kipman725/Petri2/temp_accuracy.png

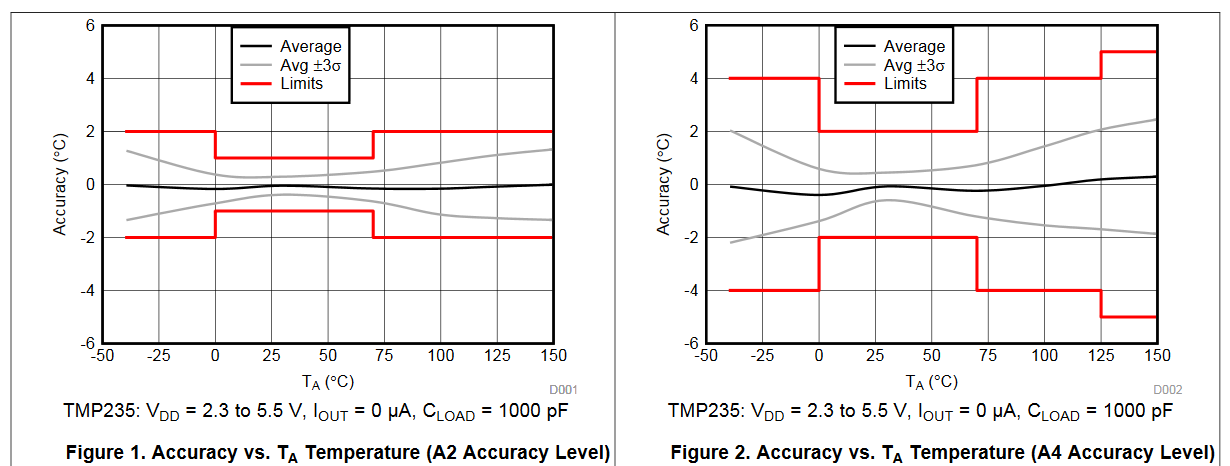
temp_accuracy.png
