kipman725/Petri2/dxf/projection_holes_fusion360.dxf

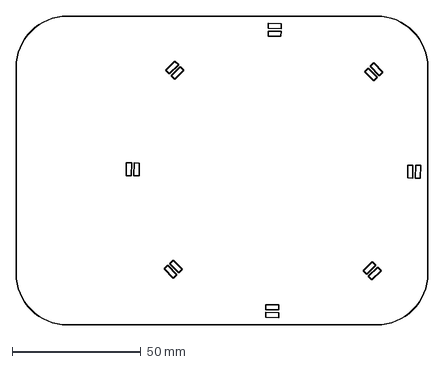
[picture p2: CAD file, 2020-06-29]
dxf/projection_holes_fusion360.dxf
160.0 x 120.0 mm
