kipman725/Petri2/stl/incubot_3d_stl.stl

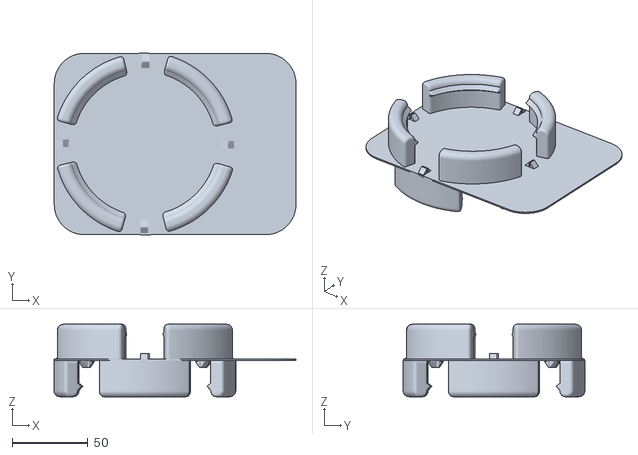
[picture p3: CAD file, 2020-06-29]
stl/incubot_3d_stl.stl
160.2 x 120.3 x 48.0
