kipman725/Petri2/stl/petri_bumper_3d_print.stl

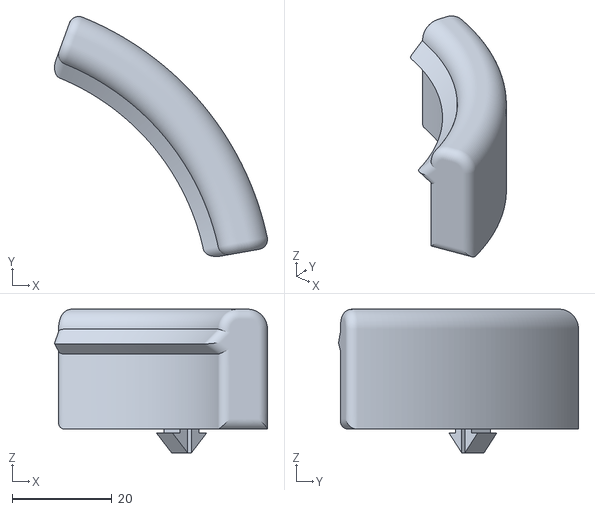
[picture p4: CAD file, 2020-06-29]
stl/petri_bumper_3d_print.stl
42.6 x 48.0 x 28.7
