kipman725/Petri2/PCB/Petri.kicad_pcb

## KiCad design PCB/Petri.kicad_pcb (2020-06-30)

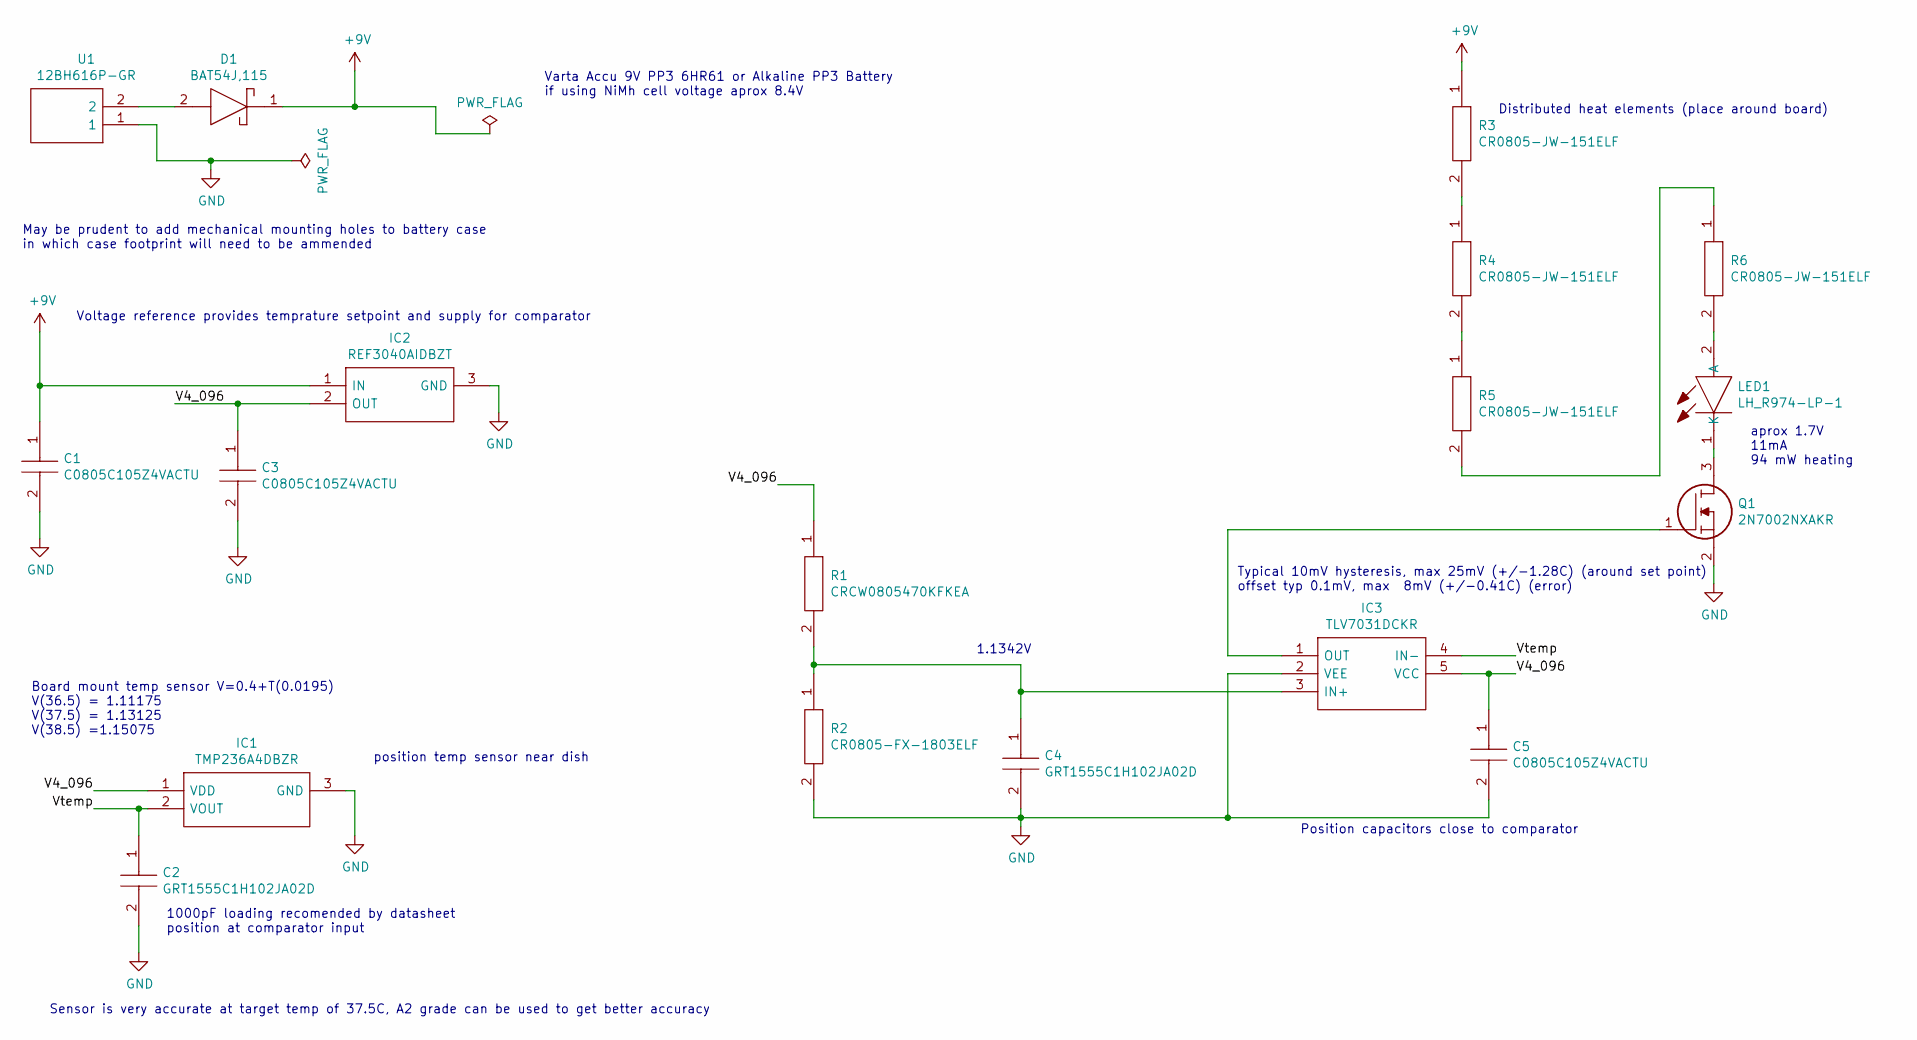
[picture p5: schematic Petri.sch]

Parts:
C1, C3, C5: C0805C105Z4VACTU; CAPC2013X140N; Mouser Part Number 80-C0805C105Z4V
C2, C4: GRT1555C1H102JA02D; CAPC1005X55N; Mouser Part Number 81-GRT1555C1H102JA2D
D1: BAT54J,115; SODFL2512X80N; Mouser Part Number 771-BAT54J115
IC1: TMP236A4DBZR; SOT95P237X112-3N; Mouser Part Number 595-TMP236A4DBZR
IC2: REF3040AIDBZT; SOT95P237X112-3N; Mouser Part Number 595-REF3040AIDBZT
IC3: TLV7031DCKR; SOT65P210X110-5N; Mouser Part Number 595-TLV7031DCKR
LED1: LH_R974-LP-1; LEDC2012X90N; Mouser Part Number 720-LHR974-LP-1
Q1: 2N7002NXAKR; SOT95P230X110-3N; Mouser Part Number 771-2N7002NXAKR
R1: CRCW0805470KFKEA; RESC2012X50N; Mouser Part Number 71-CRCW0805470KFKEA
R2: CR0805-FX-1803ELF; RESC2012X60N; Mouser Part Number 652-CR0805FX-1803ELF
R3, R4, R5, R6: CR0805-JW-151ELF; RESC2012X60N; Mouser Part Number 652-CR0805JW-151ELF
U1: 12BH616P-GR; 12BH616PGR; Mouser Part Number 12BH616P-GR

Connections:
+9V: C1.1, D1.1, IC2.1 (IN), R3.1
/V4_096: C3.1, C5.1, IC1.1 (VDD), IC2.2 (OUT), IC3.5 (VCC), R1.1
/Vtemp: C2.1, IC1.2 (VOUT), IC3.4 (IN-)
GND: C1.2, C2.2, C3.2, C4.2, C5.2, IC1.3 (GND), IC2.3 (GND), IC3.2 (VEE), Q1.2, R2.2, U1.1
unnamed: C4.1, IC3.3 (IN+), R1.2, R2.1
unnamed: D1.2, U1.2
unnamed: IC3.1 (OUT), Q1.1
unnamed: LED1.1 (K), Q1.3
unnamed: LED1.2 (A), R6.2
unnamed: R3.2, R4.1
unnamed: R4.2, R5.1
unnamed: R5.2, R6.1

Notes on the sheet:
Varta Accu 9V PP3 6HR61 or Alkaline PP3 Battery if using NiMh cell voltage aprox 8.4V
May be prudent to add mechanical mounting holes to battery case in which case footprint will need to be ammended
Voltage reference provides temprature setpoint and supply for comparator
Board mount temp sensor V=0.4+T(0.0195) V(36.5) = 1.11175 V(37.5) = 1.13125 V(38.5) =1.15075
1000pF loading recomended by datasheet position at comparator input
Typical 10mV hysteresis, max 25mV (+/-1.28C) (around set point) offset typ 0.1mV, max 8mV (+/-0.41C) (error)
Sensor is very accurate at target temp of 37.5C, A2 grade can be used to get better accuracy
1.1342V
Position capacitors close to comparator
Distributed heat elements (place around board)
aprox 1.7V 11mA 94 mW heating
position temp sensor near dish

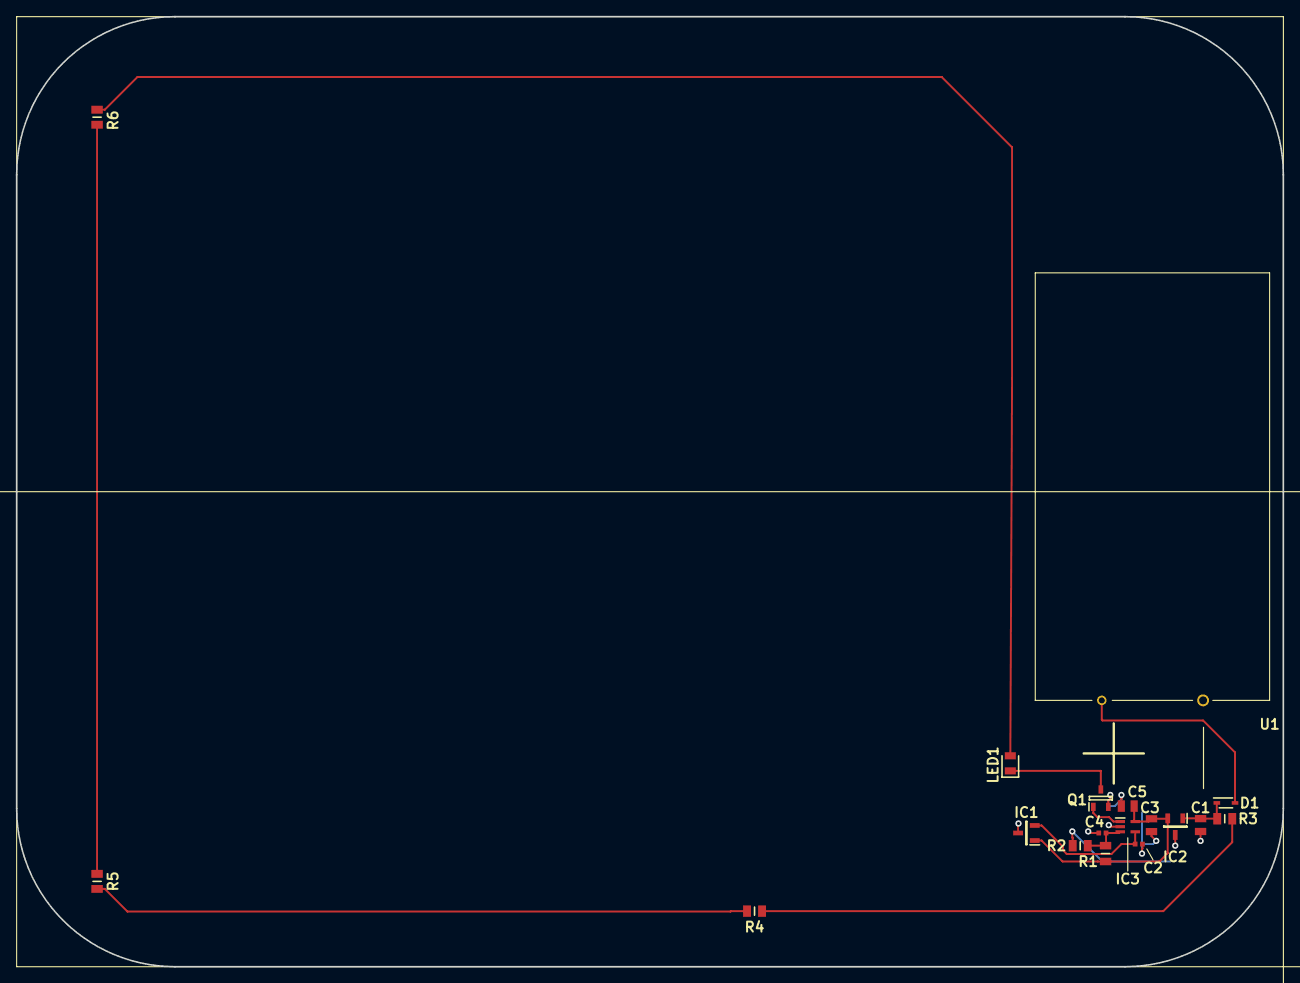
[picture p6: board Petri.kicad_pcb from above]

Board: 2 copper layers, 160.0 x 120.0 mm, 18 parts (0 on the bottom side), 12 nets.
