kipman725/Petri2/(commit log)

2020-06-28 Added dxf for real
    :)
    [projection_holes.dxf]
2020-06-28 Update projection_holes.dxf
    uploaded the right file this time
    [projection_holes.dxf]
2020-06-29 added models
    need to design cover after components are in place
    [incubot_3d_stl.stl, petri_bumper_3d_print.stl, projection_holes.dxf, projection_holes_fusion360.dxf]
2020-06-29 PCB
    should add pcb
2020-06-29 PCB
    Fixed nested git error should now work
    [Petri.kicad_pcb, Petri.sch]
2020-06-30 Updated PCB
    work completed:
    - added proper dxf edge cuts from fusion file
    - rerouted some tracks and positioned battery
    to be done:
    - position battery holder exactly at ½ height
    - add cuts for case (staggered?)
    [Petri.kicad_pcb]
